shenyanf/NixieTubeClock/BOM/BOM.xls

商品明细列表
序号 | 商品编号 | 厂家型号/封装 | 商品名称 | 订购数量 | 单价(在线支付) | 金额(在线支付)
1 | C26545 | 暖白3528LED灯珠/3528 | 暖白 3528 LED灯珠 编带 环保 | 50个 | ￥0.0436/个 | ￥2.18
2 | C55509 | L78M05CDT-TR/DPAK | L78M05CDT-TR 编带 环保 | 1片 | ￥1.00/片 | ￥1.00
3 | C41846 | XL-2838L/直插 | 接收头（塑封鼻梁状接收距离远） 袋装 环保 | 1只 | ￥1.00/只 | ￥1.00
4 | C9866 | DS3231SN/SOIC16_75MM | DS3231SN 编带 环保 | 1片 | ￥13.27/片 | ￥13.27
5 | C59928 | HV221M016E077R/6.3*7.7 | 220uF 16V 编带 环保 | 10只 | ￥0.326/只 | ￥3.26
6 | C34268 | RS1G/SMA | RS1G 编带 环保 | 50个 | ￥0.054/个 | ￥2.70
7 | C8515 | MMBTA42 1D/SOT-23-3 | MMBTA42 编带 环保 | 20个 | ￥0.1175/个 | ￥2.35
8 | C53425 | DC50插座 温度范围-30~70℃ 耐压AC50/9x11x14.2 | DC50 φ5.5插座 温度范围-30~70℃ 耐压AC50 袋装 环保 | 5个 | ￥0.596/个 | ￥2.98
9 | C10152 | SMDRI127-331MT/127 | 330uH ±20% 编带 | 2只 | ￥1.00/只 | ￥2.00
10 | C9836 | CR1220-2/贴片 | CR1220-2 电池卧式底坐 盒装 环保 | 1个 | ￥1.00/个 | ￥1.00
11 | C32078 | MC34063ADR2G/SOIC8_39MM | MC34063ADR2G 编带 环保 | 1个 | ￥1.14/个 | ￥1.14
12 | C59368 | KM100M250F115A/8*11.5 | 10uF 250V 袋装 环保 | 10只 | ￥0.292/只 | ￥2.92
13 | C36578 | 1N4007W A7/SOD-123FL | 1N4007W A7 编带 环保 | 50个 | ￥0.0476/个 | ￥2.38
14 | C5408 | 纽扣电池/CR1220/ | 电池/ CR1220 盒装 环保 | 1个 | ￥1.00/个 | ￥1.00
15 | C20818 | SMD2018P100TF/SMD-2018 | 1.00A 自恢复型 | 5片 | ￥0.476/片 | ￥2.38
16 | C5446 | XC6206P332MR/SOT-23-3 | XC6206P332MR 编带 环保 | 1个 | ￥1.00/个 | ￥1.00
17 | C8735 | STM32F103RBT6/LQFP64_10X10X05P | STM32F103RBT6 托盘 环保 | 2个 | ￥13.66/个 | ￥27.32
18 | C2646 | IRF840STRPBF/TO-263-2(DDPAK) | IRF840STRPBF 编带 环保 | 1片 | ￥5.97/片 | ￥5.97
19 | C8077 | ZMM75/LL-34 | ZMM75 编带 环保 | 10片 | ￥0.169/片 | ￥1.69
20 | C18560 | 8MHz ±20PPm 20pF/5032_2P | 8MHz ±20ppm 20pF 编带 环保 | 2个 | ￥1.40/个 | ￥2.80
21 | C37634 | S9013W/SOT-323 | S9013W J3 编带 环保 | 10个 | ￥0.13/个 | ￥1.30
