shenyanf/NixieTubeClock/NIXIEClock_SCH.pdf

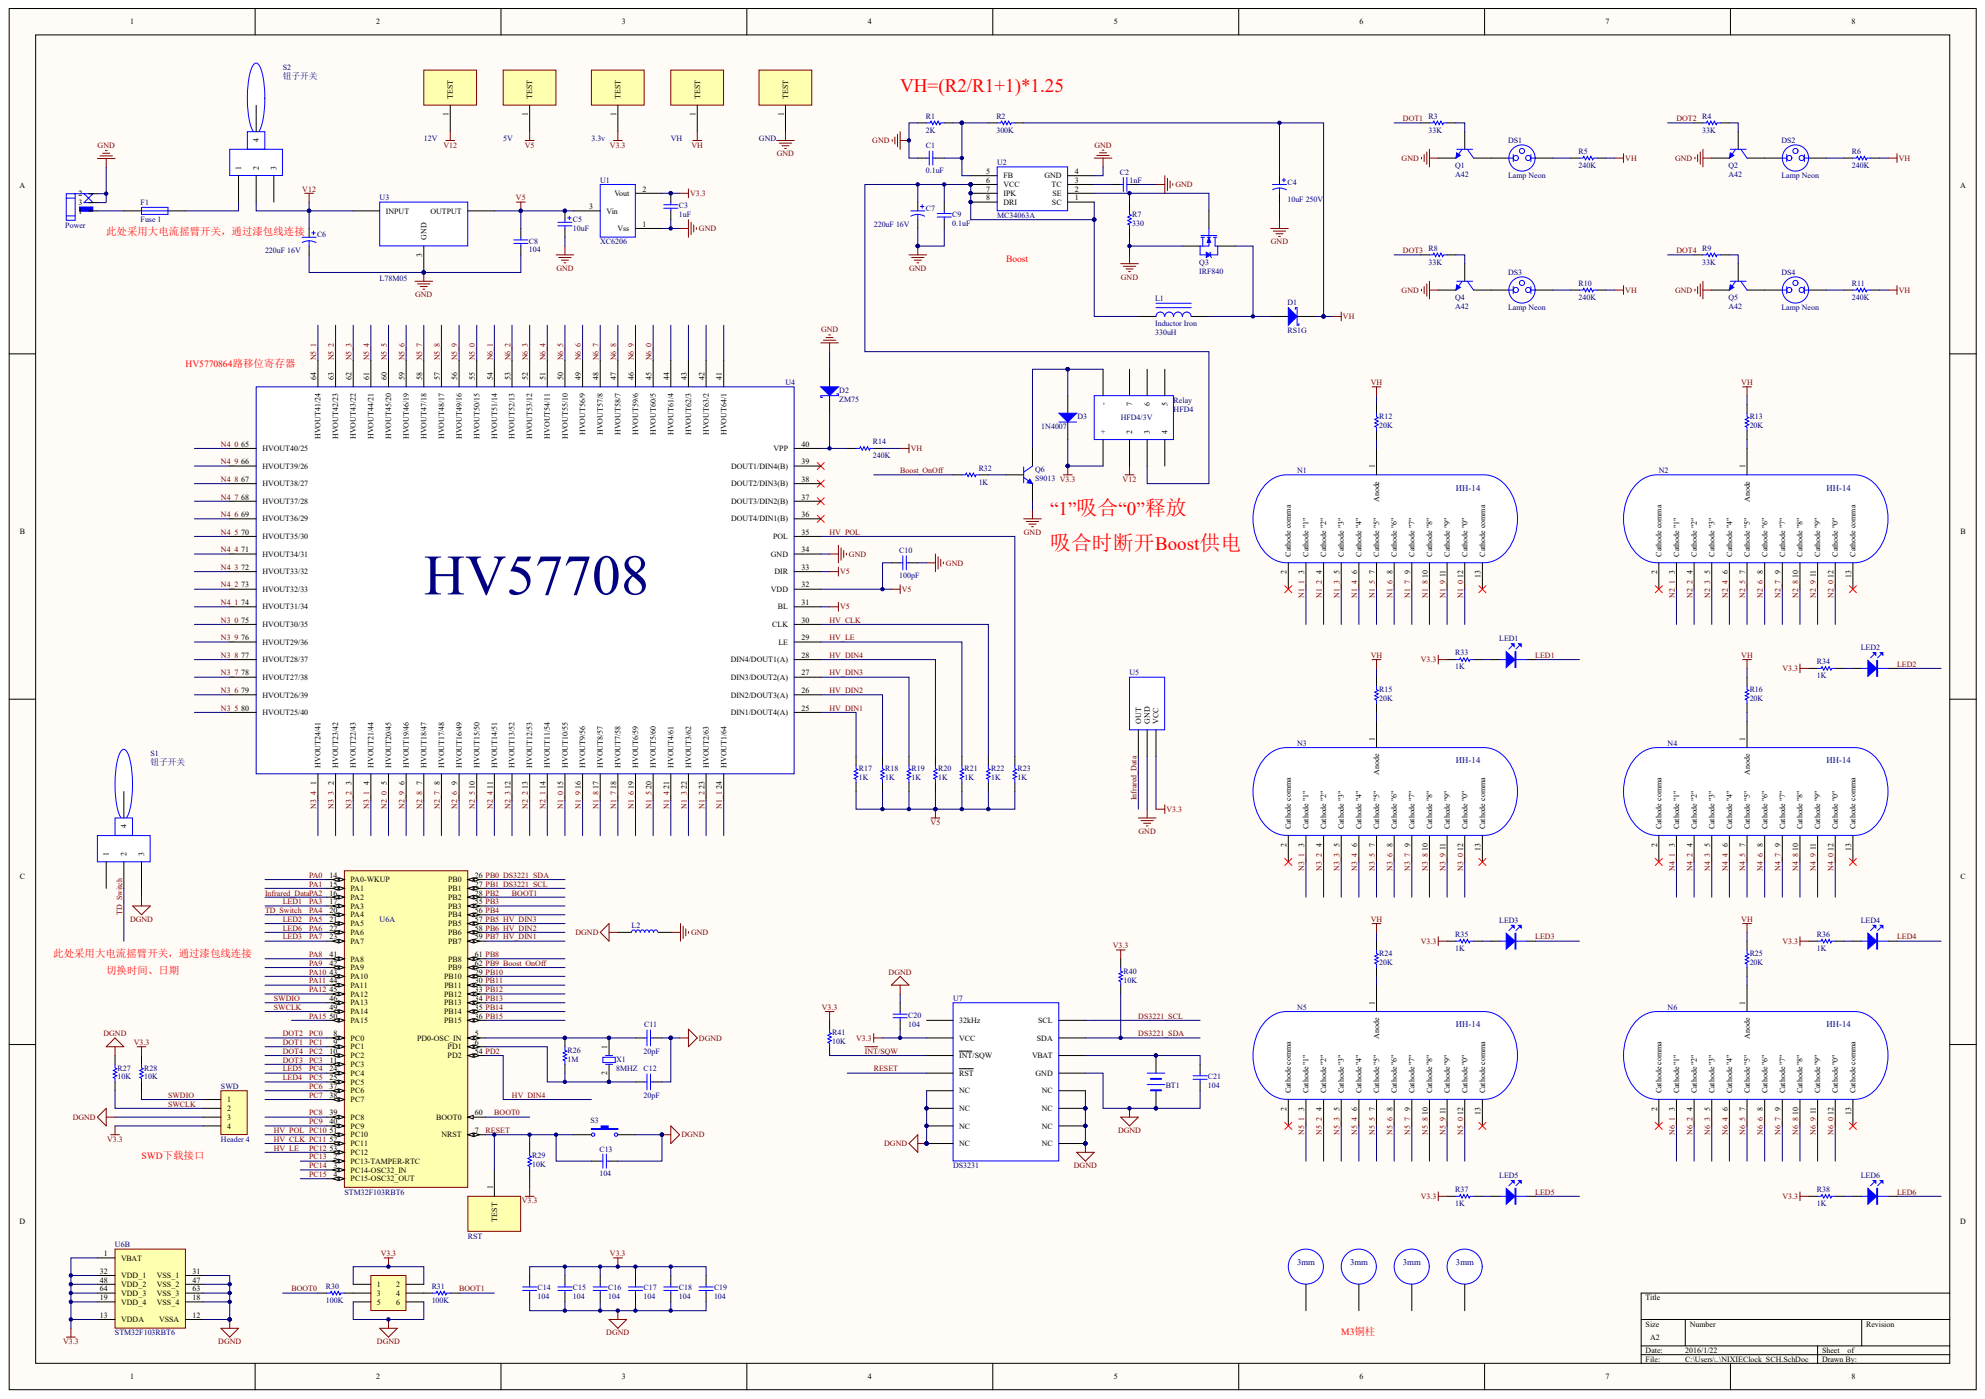
[picture p3: page 1]
