shenyanf/NixieTubeClock/NIXIEClock_PCB/NIXIEClock_151223.pdf

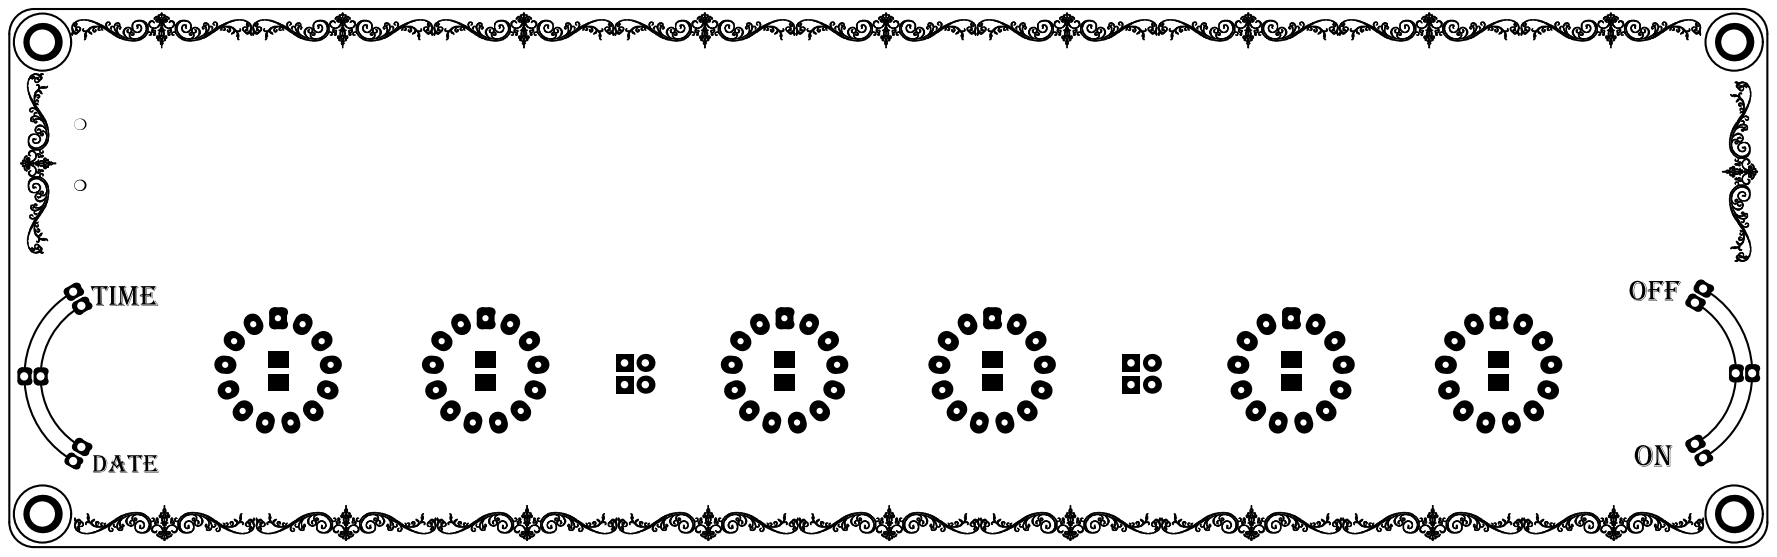
[picture p4: page 1]
