shenyanf/NixieTubeClock/(list of files, drawings)

Other design files:
NIXIEClock_PCB/NIXIEClock.PrjPCB
NIXIEClock_PCB/NIXIEClock_151223.PcbDoc
NIXIEClock_PCB/NIXIEClock_151223.PcbLib
NIXIEClock_PCB/NIXIEClock_SCH.SchDoc
NIXIEClock_PCB/NIXIEClock_SCHLib.SchLib
