shenyanf/NixieTubeClock/(commit log)

2016-05-17 add all file
    [BOM.xls, NIXIEClock.PrjPCB, NIXIEClock_151223.PcbDoc, NIXIEClock_151223.PcbLib, NIXIEClock_SCH.SchDoc, NIXIEClock_SCHLib.SchLib]
2016-05-17 add some content
    [BOM.xls]
